Crowdedlight/DreamTeamCar/README.md

# DreamTeamCar
Repository for all code and documents regarding our AI Car project
