Crowdedlight/DreamTeamCar/Tex Filer/Include/Forside.tex

\begin{titlepage}
\begin{center}

% Upper part of the page. The '~' is needed because \\
% only works if a paragraph has started.

%keepaspectratio, trim={0.33\textwidth} {0.67\parentheight} {0.33\textwidth} 0, clip

%\includegraphics[width=1\textwidth, page=7, trim={0.06\textwidth} {0.025\textwidth} {0.06\textwidth} {0.025\textwidth}, clip]{logo.pdf}~\\[0.5cm]

\textsc{\Huge Syddansk Universitet}\\[1.5cm]
\textsc{\huge \color{sdu_grey} Mærsk McKinney Møller Instituttet}\\[0.5cm]

\textsc{\LARGE \color{sdu_grey} Robot Teknologi}\\[0.5cm]

% Title
\HRule \\[1ex]
{ \Huge \bfseries Pole Position \\[1ex] }

\HRule \\[1.5cm]

% Author and supervisor 
\begin{minipage}{0.50\textwidth}
\begin{flushleft}\large
\emph{Gruppe 7:}\\
\vspace{4mm}
Peter Gilsaa \\
05/05-95 \\
\href{mailto:pegil14@student.sdu.dk}{\color{sdu_blue}pegil14@student.sdu.dk}\\
\vspace{4mm}
Mads Tilgaard Jensen\\
04/01-94 \\
\href{mailto:madst14@student.sdu.dk}{\color{sdu_blue}madst14@student.sdu.dk}\\
\vspace{4mm}
Eskild Andresen\\
27/03-92 \\
\href{mailto:esand14@student.sdu.dk}{\color{sdu_blue}esand14@student.sdu.dk}\\
\vspace{4mm}
Sara Marie Gadgaard\\
04/09-92 \\
\href{mailto:sagad13@student.sdu.dk}{\color{sdu_blue}sagad13@student.sdu.dk}\\
\vspace{4mm}
Frederik Mazur Andersen\\
01/11-93 \\
\href{mailto:fande14@student.sdu.dk}{\color{sdu_blue}fande14@student.sdu.dk}\\
\end{flushleft}
\end{minipage}
\begin{minipage}[c][2cm]{0.45\textwidth}
\begin{flushright} \large
\vspace{2cm}
\emph{Kursus Kode:} \\
RB-AUR2-U1 \\
\vspace{2cm}
\emph{Vejleder:} \\
Dorthe Sølvason  \\
\vspace{2cm}
\emph{Projekt Udleveret:} \\
27. Februar 2015 \\
\vspace{4mm}
\emph{Projektet afleveret:} \\
27. Maj 2015
\end{flushright}
\end{minipage}

\vfill

% Bottom of the page
{\Large Autonome Robotter 2}
\end{center}
\end{titlepage}
