Crowdedlight/DreamTeamCar/Tex Filer/Include/Informationer.tex

\section*{Informationer}
\begin{tabularx}{\hsize}{lX}
Kursus:		    &	Autonome robotter\\
Projekttitel:	&	Pole Position\\
Gruppe:			&	7\\
Vejleder:		&	Dorthe Sølvason\\
\\
Universitet:	&	Syddansk Universitet\\
Periode:		&	27. Februar - 27. Maj 2015\\
Uddannelse:		&	Robotteknologi\\
\\
Sideantal:		&	\pageref{LastPage} \\
CD:				&	$ATmega32A$ $Datasheet.pdf$     \hspace{1.85cm}   $AVR$ $Instruction$ $Set.pdf$ \\
                &   $CNY70$ $Datasheet.pdf$         \hspace{2.6cm}   $L293$ $Datasheet.pdf$ \\
                &   $LIS35DE$ $Datasheet.pdf$       \hspace{2.3cm}   $Lookup-Tabel-Bremse.xlsx$ \\
                &   $MMA1270KEG$ $Datasheet.pdf$    \hspace{1.05cm}   $Rapport.pdf$ \\
                &   $Sensorboard\_tegning.pdf$      \hspace{2.1cm}   $TCST1230$ $Datasheet.pdf$ \\
                &   $Tidsplan.pdf$

\\

Underskrifter:\\
\end{tabularx}
\vspace{1.3cm}
%%%%%%%%%%%%%%%%%%%%%%%%%%%
% Underskrift

%%%%%%%%%%%%%%%%%%%%%%%%%%%
\noindent\begin{tabularx}{\hsize}{XX}
\\
--------------------------------------------- & --------------------------------------------- \\
Eskild Andresen & Frederik Mazur Andersen \\

\\\\\\\\
--------------------------------------------- & --------------------------------------------- \\
Mads Tilgaard Jensen & Peter Gilsaa \\
\\\\\\\\
--------------------------------------------- &  \\
Sara Marie Gadgaard  \\
\end{tabularx}
