Crowdedlight/DreamTeamCar/Tex Filer/Include/Litteraturliste.tex

\section{Litteraturliste}
\subsection{Kilder}
\begin{enumerate}
\item Atmel, 8-bit AVR: Instruction Set.(PDF), \\
\url{https://e-learn.sdu.dk/bbcswebdav/pid-3951952-dt-content-rid-5381354_2/courses/RB-AUR2-U1-1-F15/AVR\%20Instruction\%20Set\%281\%29.pdf} 26/05-2015
\item Muhammed Ali Mazidi, Sarmad Naimi og Sepehr Naimi: AVR Microcontroller and Embedded System: Using Assembly and C, 2011
\item Schoolphysics: Circular Motion, Cars on flat track, \\
\url{http://www.schoolphysics.co.uk/age16-19/Mechanics/Circular\%20motion/text/Cars_cornering/index.html} 20/05-2015.
\item Søren Hassing og René Skov Hansen: Elektrofysik (E-ANA 1), supplerende noter.(PDF), Efterår 1997
\end{enumerate}

\subsection{Datasheets}
\begin{enumerate}
\item Atmega32A - Atmel, \\
\url{https://e-learn.sdu.dk/bbcswebdav/pid-3951952-dt-content-rid-5381352_2/courses/RB-AUR2-U1-1-F15/ATmega32A\%20datasheet\%281\%29.pdf} 26/05-2015
\item CNY70 - Vishay, \\
\url{http://www.vishay.com/docs/83751/cny70.pdf} 26/05-2015
\item L293 - Texas, \\
\url{http://users.ece.utexas.edu/~valvano/Datasheets/L293d.pdf} 26/05-2015
\item MMA1270KEG - Freescale Semiconductors, \\
\url{http://cache.freescale.com/files/sensors/doc/data_sheet/MMA1270KEG.pdf} 26/05-2015
\item TCST1230 - Vishay, \\
\url{http://www.vishay.com/docs/83765/tcst1230.pdf} 26/05-2015
\end{enumerate}
