Crowdedlight/DreamTeamCar/Tex Filer/Include/motorstyr_brems.tex

\section{Motorstyring og bremsning}
For at finde den bedste måde at bremse på, er der lavet en test med tre scenarier. I alle tre scenarier er banen den samme. Banen består af ti lige skinner. De første seks er tilsluttet strømforsyningen, mens de fire sidste er tilsluttet en kontakt, så skinnerne kan frakobles strømforsyningen, kortsluttes eller strømmen kan vendes. Motoren er koblet direkte til banen, dvs. at den styres vha. strømforsyningen. I alle test er spændingsfaldet over motoren på 15volt. Det hele filmes. \\

I første test var de sidste fire skinner ikke tilsluttet til strømforsyningen ydermere var de ikke kortsluttet. Her viste testen at bilen skulle bruge mere end 70cm for at stoppe helt. \\
I anden test var de sidste fire skinner kortsluttet. Dvs. at motoren blev kortsluttet efter at have kørt på de seks første skinner. Her var bremselængden 67cm. \\
I tredje test og sidste test løb strømmen den modsatte vej igennem motoren på de sidste fire skinner. Her var bremselængde kun 32cm. \\

En H-bro er et kredsløb som kan styre en motor. Den er som regel opbygget af NPN/PNP transistor eller MOSFETS og kan fås som IC'er så som L293. L293 er opbygget af NPN/PNP transistorer. Ved at tilslutte motoren til en H-bro giver det mulighed for at styre retningen af motoren og at kortslutte motoren. Muligheden for at styre retningen af motoren, bruges til bremsning af bilen.

For at kunne vende strømmen i motoren er der placeret en H-bro. H-broen der anvendes er L293. Denne IC består af to H-broer, det er dog kun den ene som anvendes. H-broen har 3 forbindelser til microcontrolleren: enable, 1A og 2A. Disse tre forbindelser bruges til at styrer motoren. Se figur \ref{hbro_forbindelse} for mulige kombinationer. 

\begin{figure}[h!]
\center
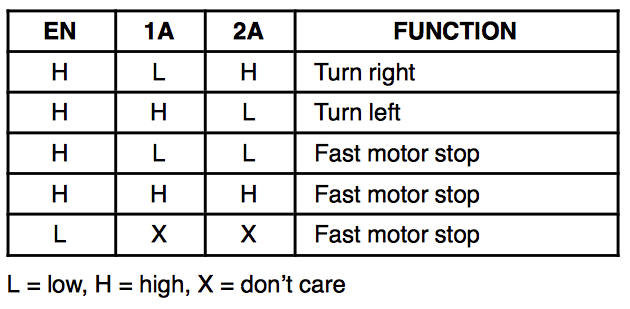
[picture p10: Tex Filer/Graphics/h-bro_forbindelse.png]

\caption{H-broens 3 forbindelser og hvordan de kan sættes}
\label{hbro_forbindelse}
\end{figure}

PWM signalet fra microcontrolleren er koblet til 1A, mens enable og 2A er koblet til I/O pins. Som det ses i figur \ref{hbro_forbindelse} vil et PWM signal medføre at motoren skifter mellem "Fast motor stop" og "turn left". Dette er dog ikke et problem da man på lige strækninger kører med 100\% PWM hvilket svarer til at 1A konstant er høj. Derfor får man ikke lavere topfart i forhold til at køre uden H-bro. Dog vil det kræve et højere PWM signal for at holde samme fart i svingene i forhold til uden at bruge H-broen. Dette medvirker at bilen har et højere energiforbrug og mere spild energi, men der er intet krav om at bilen skal være effektiv. \\

Ved opbremsning ”slukkes” for PWM signalet og 2A sættes høj. Dette medfører at spændingen over motoren vendes. Opbremsningen sker kun kortvarigt indtil bilen kommer ned i en hastighed, hvor at den ikke falder af i svingene. For at finde det optimale tidspunkt at bremse på er der lavet en række test og beregninger. Dette kan der læses nærmere om i afsnit \ref{bremse}.
