Crowdedlight/DreamTeamCar/Tex Filer/Include/Forord.tex

\renewcommand{\abstractname}{Forord}
\section{Forord}
Rapporten er udarbejdet af studerende fra 2. semester, derfor henvender rapporten sig til studerende fra 2. semester eller højere. \\
Formålet er at give læseren en forståelse, overblik over projektets omfang og lede læseren frem til løsningen af det færdige projekt.\\
Rapporten er bygget op omkring projektet Pole Position.\\
