Crowdedlight/DreamTeamCar/Tex Filer/Include/Resume.tex

\newpage
%\thispagestyle{empty}
%\renewcommand{\abstractname}{Resume}
\section{Resume}
Denne rapport er dokumentation for en modificeret racerbil. Bilen er modificeret således at den kan justere sin hastighed hensigtsmæssigt og derved opnå den hurtigste omgangstid.\\
For at realisere dette er bilen udstyret med tre sensorer: En reflektiv optisk sensor, et accelerometer og transmissiv optisk sensor. Disse sensorer, samt elektromagnet og opbremsning håndteres af en microcontroller der forbinder disse elementer og gør bilen selvstændig. Bilen vil bestræbe sig på at køre med hurtigste omgangstid, med den kunstige intelligens, der er blevet lavet.\\ Flere sensorer, magneter og bremsemetoder er overvejet og testet før implementering. \\
