Crowdedlight/DreamTeamCar/Tex Filer/Rapport.pdf

Faculty of Engineering

Robotic Technology

# Pole Position

Gruppe 7:

Peter Gilsaa
pegil14@student.sdu.dk

Mads Tilgaard Jensen
madst14@student.sdu.dk

Eskild Andresen
esand14@student.sdu.dk

Sara Marie Gadgaard
sagad13@student.sdu.dk

Frederik Mazur Andersen
fande14@student.sdu.dk

Vejleder:
Dorthe Sølvason

Projekt Udleveret:
27. Februar 2015
Projektet afleveret:
27. Maj 2015

## Autonome Robotter 2

Pole Position

## Informationer

Kursus: | Autonome robotter
Projekttitel: | Pole Position
Gruppe: | 7
Vejledere: | Dorthe Sølvason
Universitet: | Syddansk Unniversitet
Periode: | 27. Februar - 27. Maj 2015
Uddannelse: | Robotteknologi

Sideantal:
CD: | Indholde?
Underskrifter:
——————————————— | ———————————————
Eskild Andersen | Frederik Mazur Andersen
——————————————— | ———————————————
Mads Tilgaard Jensen | Peter Gilsaa

———————————————
Sara Marie Gadgaard

Peter Gilsaa, Mads Tilgaard Jensen, Eskild Andresen, Sara Marie Gadgaard & Frederik Mazur Andersen

Side 1 af 26

Pole Position | 1. Resume

## 1 Resume

Denne rapport er dukumentation for en modificeret racer bil. bilen er modificeret således at den kan justere sin hastighed hensigtsmæssigt og derved opnå den korteste omgangstid. For at realisere dette er bilen udstyret med tre sensor: En reflektiv optisk sensor, et accelerometer og transmissiv optisk sensor. Disse sensorer, samt elektromagnet og bremse håndteres af en microcontroller der forbinder disse elementer og gør bilen selvstændig. Bilen vil bestræbe sig på at køre med hurtigste omgangstid, med den kunstige intelligens den er blevet lavet.
sensorer, magnet og bremse metode er overvejet før valg.

## 2 Forord

Rapporten er udarbejdet af 2. semester studerende derfor henvender rapporten sig også til 2. semetser studerende eller højre.
Formålet er at give læseren en forståelse og overblik for projektets omfang og lede læseren frem til løsningen af det færdige projekt.
Rapporten er bygget op omkring projektet pole position.

Side 2 af 26

Pole Position | INDHOLD

## Indhold

1 Resume | 2
2 Forord | 2
3 Indledning | 5
4 Stregsensor | 6
5 Elektromagnet | 7
6 Måling af farten - Wheelspeed Sensor | 9
7 Måling af afstand - Wheelspeed Sensor | 12
8 Motorstyring og bremsning | 12
9 Sving og Bremse | 13
10 Stregsensor | 16
11 Elektromagnet | 17
12 Kommunikation mellem computer og bil | 18

Side 3 af 26

Pole Position | INDHOLD
13 Litteraturliste | 20
13.1 Kilder | 20
13.2 Datasheets | 21
14 Ordliste | 21
15 Symbolliste | 21
16 Bilag | 22
16.1 Elektromagnet-kraftmåling | 23
16.2 Beregning af gearing | 25
16.2.1 Periode tid ved 4 m/s | 25
16.3 Lookup Table - Bremse Værdi | 25

## Todo list

indsæt afsnit for konstant hastighed og mapning | 9
indsæt datablad | 10
TCST1230 s. 3 | 10
indsæt datablad | 11
henvis til lookup table og sørg for table har korrekte enheder | 11
indsæt afsnit label | 12
indsæt afnist | 12
Skal dette med? | 13
afsnit udfyldes | 13
kort intro | 13
Hvilket bilag? | 20
lav en beregning fra tid til m/s, og forklar hvad enhed tiden er | 25

Side 4 af 26

Pole Position | 3. Indledning

## 3 Indledning

skriv noget kort om indledning

### 3.1 Projekt beskrivelse

skriv noget kort om projekt beskrivelsen

### 3.1.1 Problemanalyse

Projektet skal få en elektrisk bil at hurtigst muligt at kører omgange på en vilkårlig bane uden at ryge af banen. For at opnå dette kræves forskellige sensorer som skal bygges og programmeres. Formålet er at opnå kendskab med programmering i Assembler og opbygning af sensor kredsløb, samt få programmering og sensorer til at arbejde sammen. Projektet kan opskrives til følgende:

- Bluetooth Kommunikation med bilen via en bestemt Bluetooth protokol
- Byg og monter sensor kredsløb til de forskellige nødvendige sensorer
- Algoritme der kortlægger banen
- Algoritme der bruger den kortlagt bane og sensor data til at sætte optimal hastighed

### 3.1.2 Problemformulering

Hvordan opbygges og programmeres en elektrisk bil til selv at kunne kører hurtigste tid på en vilkårlig bane? Denne problemstilling vil vi arbejde med i dette projekt, og dertil skal disse problemer løses:

- Hvordan kommunikerer man med bilen?
- Hvilke sensorer skal benyttes for at gøre bilen selvkørende med så høj fart som

muligt?
- Hvilken elektromagnetisk sensor/ Aktuator skal bruges?
- Hvordan detekteres målstregen med en sensor?
- Hvordan programmeres Micro kontrolleren så den kan kortlægge den vilkårlige bane?
- Hvordan programmeres bilen til at udnytte den kortlagte bane til at kører hurtigst

muligt?
- Hvordan fås bilen til aktivt at bremse?

### 3.1.3 Afgrænsning

I denne opgave begrænser vi os til bygge sensorer kredsløb og programmere Micro kontrolleren til den elektriske bil. Vi skal ikke bygge bilen fra bunden, men modificerer en eksisterende model til at kunne styres gennem vores Micro kontroller. Bluetooth kommunikations protokollen er også bestemt for os, men vi skal selv implementerer denne og kan

Side 5 af 26

Pole Position | 3.2 Rapportstruktur

også udvide den.

Derudover laver vi et lille program der kan snakke sammen med bilen til brug for testing og data modtagelse. Dette program er skrevet i Vb.net for ikke at bruge for meget tid og energi på det, da det kun benyttes til udvikling af bilen.

Vores projekt kan derfor fortolkes til at programmerer en Micro Kontroller til at modtage signaler fra sensorer og derudfra kortlægge en bane og give signaler til motoren for at sætte den hurtigste omgangstid.

### 3.1.4 Konkurrenceregler

Den 29. maj 2015 afholdes poleposition konkurrencen. Her vinder det hold som har den korteste omgangstid. Der er visse krav til bilen for at gøre konkurrencen fair. Bilen skal kunne køre af sig selv og skal således starte når den sættes på banen. Det skal dog være muligt at sætte en hastighed eller stoppe bilen vha. bluetooth. Denne kommunikation skal overholde en protokol som senere vil blive uddybet. Selve banen består kun af rene højre eller venstre sving, dvs. at der minimum vil være en lige skinne mellem to sving. Bilens karosseri, dæk og undervogn må ikke ændres. Det er dog tilladt at lave mindre ændringer for at gøre plads til sensorer og lignende. Der må monteres permamagneter på bilen. Magneten som er monteret på bilen fra frabrikken må dog blive siddende. Der skal anvendes en elektromagnetisk sensor og/eller aktuator i projektet. Dette kan f.eks. være i

form af en elektromagnet.

### 3.2 Rapportstruktur

## 4 Stregsensor

På kørebanen til konkurrencen er der en hvis streg, som makere start. Det ønskes at kunne detektere dennne streg, for af vide hvornår bilen har kørt en omgang.
Til at dektektere start linjen, som er hvid skal den valgte sensor detekterer foreskellen mellem hvid og stort på banen.

Til det pågældende formål er en reflektiv optisk sensor blevet undersøgt og valgt. Den reflektive optiske sensore har fordelen at den er lille og fylder lidt.

### 4.1 CNY70

Den refleksive optiske sensor som er valgt, hedder CNY70. Sensoren fylder 7x7x6 mm og er placeret 0.2 mm fra den overflade den operere på.
CNY70’eren er fastmonteret på undervognene af bilen, som vender ned mod banen.

Side 6 af 26

Pole Position | 5. Elektromagnet

sensoren består af en diode og en fototransistor, da både diode og fototransistor vender ned mod banen, fungere den ved at lyset fra dioden reflektere i banen og fototransistoren opfangere det reflekterede lys og åbner alt efter hvor meget der bliver reflekteret.
Mørke farver absobere meget af lyset mens lyse farver reflektere dem.
(henvis til kredsløb for stregsensor)sensoren er forsynet med 5V, men kun når diodens

stråler reflekteres åbner transistoren og udgangsspændingen på output-benet bliver højt. Programmet til stregsensoren tjekker først på rising edge og registrere dette, så tjekker den for falling edge og registrere dette, microcontrolleren har nu dektekteret hele målstregen.

## 5 Elektromagnet

Elektromagneten er lavet til at holde bilen på banen. ved at aktivere elektromagneten sving burde den optimere bilens evne til at holde sig på banen, ved højre hastighed end udens elektromagnet.

### 5.1 Kernemateriale

En vigtig faktor i fremstilling af elektromagneter er materialet. Ud fra materialet bestemmes, elektromagnetens magnetiake evne, hvori materialets permabiliteten bestemmer hvor det kan lede et magnetisk felt. Permeabiliteten kan deles op i tre underemner, ferromagnetisk, paramagnetisk og diamagnetisk.
I diamagnetiske materialer er magnetiseringen ekstremt lille og har en lineær BH-kurve. Ved paramagnetiske materialer er magnetiseringen ligeledes meget lille, men større end diamagnetiske materialer og ligeledes har materialet en lineær BH-kurve. Ferromagnetiske materialer har en stor magnetisering, den magnetiske effekt skyldes herved de uparede elektroner der forekommer i nogle metaller. Ferromagnetiske materialer har en logistisk stigende HB-kurve.

Ferromagnetisk materiale kan nu deles op i to undergrupper, blødt materiale og hårdt materiale. Blødt materiale er er karakteret ved høj permeabilitet, lille hysteresekurve med lille koerciv felt og lille kulstofindhold. Bløde materialer er ofte en legering af jern og silicium eller nikkel.
Hårdt materiale er karakteriseret ved mindre permeabilitet end blødt materiale, bred hysteresekurve, stort koerciv felt og højt kulstofindhold. Hårde materialer er ofte en legering af jern med kulstof, aluminium eller wolfram.

### 5.2 Prøvemagnet

Som udgangspunkt er kernematerialet blevet antaget til at være stål da materialet er ferromagnetisk og hårdt. hvis der skulle laves en korrekt undersøgelse at kernematerialet ville

Side 7 af 26

Pole Position | 5.2 Prøvemagnet

det kræve en længere og meget tidskræven undersøgelse, derfor har dette kun været en overvejelse.
Næste overvejelse har været placering og form af elektromagnet. der er tre steder elektromagneten kan placeres på bilen, der er foran, bagpå eller under bilen.
Hverken trække eller skubbe elektromagneten er en effektiv løsning, det vil skabe uligevægt i bilen og flytte masse midtpunkt. ved en stærk elektomagnet vil man ændre friktions niveauet meget ved at have elektromagneten foran eller bagved, dvs. Hvis elektromagneten sidder bagpå vil der opstå meget friktion på baghjulene og mindre friktion på forhjulene. Fluxspredning er en faktor der skal tages hensyn til når formen til elektromagneten laves, der vil altid være fluxspredning med formen kan være med til at reducere det betydligt. fluxlinjerne beværger sig fra nord til syd for fuldt udbytte af elektromagnet bør nord og syd pol befinde sig over skinnerne så fluxlinjerne løber med skinnerne. Hvis elektromagneten formes som en hestesko vil nord og syd pege ned mod skinnerne. for at undgå for meget fluxspredning bør luftgabet imellem nord og syd i hesteskoen være så stor som muligt, men da der er begrænset plads underbilen, kan lufgabet ikke blive særlig stort og en del kraft vil gå tabt i både fluxspredning og fluxfringing (se journal).

Nu da materialet er bestemt, placeringen og formen, skal antal vindinger bestemmes, da der er en maks bredde på pladsen under elektromagneten, vil der kun være plads til en 660 vindinger, før elektromagneten vil komme for tæt på banen, hvilket vil sige den ikke må komme tættere på end 2mm da bilen har affjedring og køre skævt i svingene. elektromagneten må ikke røre skinnerne da den enten vil gå i mætning eller kortslutte, så derfor er afstanden fra elektromagneten til skinnerne vigtigt.

Test magneten er lavet ud fra forrige forhold og formlen for den magnetiske kraft i et luft gab (under idelle forhold) er givet ved:

Fmagn(x) = −

B²
g
2µ0

∗ Aj ∗ (

4x
lj
µr

+2x

− 1)

Hvor Bg er:

Bg(x) = µ0IN
lj
µr

+2x

Ud fra de overstående ligninger er kraften ideelt fundet til at være 1,309N. Virkeligt er den målt med en force sensor til at være 0,9367N. (henvis til journal)

Da 0,9367N er en meget lille kraft, bør de overvejes grundigt om elektromagneten vil blive en ulempe eller hjælp til bilen og hvor meget vil den lille kraft enlig kunne hjælpe med at forøge hastigheden i svingene. (henvis til peters afsnit)

Side 8 af 26

Pole Position | 6. Måling af farten - Wheelspeed Sensor

## 6 Måling af farten - Wheelspeed Sensor

I dette afsnit beskrives der hvordan en wheelspeed sensor udnyttes til at beregne farten bilen kører med. Der vil både blive beskrevet hardwaren til sensoren samt hvordan den softwaremæssigt bruger sensoren. Farten bliver brugt til at mappe banen samt kører med
konstant hastighed. Disse funktioner vil blive beskrevet i afsnit . | indsæt
afsnit
for konstant
hastighed og
mapning

indsæt
afsnit
for konstant
hastighed og
mapning

### 6.1 Fart Hardware - TCST1230

Vi benytter TCST1230, som er en optisk sensor, til at lave en fotogate. Sensoren består af en fotocelle og en vifte med 16 blade på. Hjulet med vifterne sidder på motorens akse og hver gang aksen drejer en omgang vil den bryde fotosensorens lys XX gange. Hver gang lyset brydes så fås en puls fra fotosensoren som sendes videre til micro-controlleren. Dette er illustreret i figur 1


Figur 1: 3D model af sensoren

Efter test er der sat flere blade på viften da for at præcist at kunne bruge målingerne fra sensoren krævede det en højere opløsning. Dette fås ved at tilføje flere blade til viften så vi får flere pulses pr. omdrejning af aksen. Der er således nu så 4 blade på viften hvilket giver os 4 pulse pr. akse omdrejning. Dette svarer til 16,8 pulses pr. hjul omdrejning.
Se afsnit ?? for udregningen af gearingen.
Dette giver en opløsning der er 4 gange bedre, end kun at have 1 vifte.
For bedre opløsning kunne der sættes flere vifter på, men kommer der for mange vifter på, vil det dog blive svært for sensoren at aflæse vifterne da deres mellemrum til sidst vil blive meget småt. Jo flere vifter der kommes på, jo sværere bliver det også at bygge ringen med vifterne.

Der bliver i dette tilfælde valgt at have 4 vifter da det kunne bygges forholdsvis let og det giver en opløsning der er høj nok til hvad vi ønskede. Ved blot 1 vifte kørte vi 2cm per omdrejning. Da vi ved hjulet kører 0,2381 omgange pr. motor omdrejning så kan længden den kører mellem hver puls udregnes ved at multiplicerer hjul omdrejninger med hjulets

Side 9 af 26

Pole Position | 6.1 Fart Hardware - TCST1230

omkreds:

0,2381 ∗ 8,5 = 2,02cm

Dette er ikke ret præcist da vi så kun kan aflæse længden/farten i intervaller af 2cm. Det

blev så sat 4 vifter på og dette giver en præcision på:

(0,2381/4) ∗ 8,5 = 0,51cm

Dette er markant bedre da den nu kun kører 0,51cm før den får en puls og udregner længde og hastighed. Så der fås flere mindre intervaller der kan tjekkes og reageres på.

Som det kan ses på tegningen af kredsløbet i figur 2 så er der sat nogle modstande og en kondensator på sensorens kredsløb.

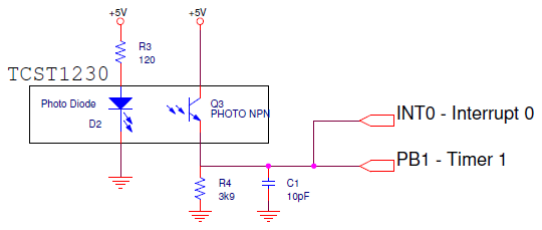
[picture p16: figure]

Figur 2: Kredsløbet til TCST1230 Sensoren

Modstanden R3 i figur 2 er der for at sørge for at strømmen over dioden D2 ikke bliver
højere end den kan tåle. Dioden kan nemlig kun klarer 30mA ifølge databladet. | indsæt
| data-
Modstanden R4 virker som en pulldown modstand der sørger for at hive signalet langt | blad
nok ned, når fototransistoren ikke modtager lys, så der er logisk lavt signal.

Kondensatoren C1 benyttes til at sorterer små signaler fra. Hvis signalet ”hopper” frem og tilbage ved en overgang fra logisk lavt til logisk højt vil kondensatoren tage de små hurtige skift og sorterer dem fra. På denne måde fjernes en del af støjen. Der blev gennem oscilloskop observeret pral på sensoren ved TTL signal behandling. Der var benyttet en forkert metode til at opbygge sensoren på. Der var anvendt en struktur som forårsagede
at diode spændingen over fototransistoren ikke kunne komme under 0.6V. Der blev derfor
udarbejdet en anden struktur som set i databadet s. 3. Modstanden benyttet til dioden | TCST1230
blev udregnet vha. Ohms lov og ved at sætte strømmen lig 30mA. Dette resulterede i en | s. 3
modstand for R3 på 120 Ohm.

Side 10 af 26

Pole Position | 6.2 Fart Software
R4, som er pulldown modstanden, blev beregnet ved at kigge på figur 8 i databladet . Her | indsæt
| data-
| blad

blev modstanden udregnet til ca. 4K Ohm. Der anvendes her en 3.9K Ohm modstand

### 6.2 Fart Software

Sensorens output er sat på ”PB1” og ”PD3” som går til ”Timer1” og ”INT0” i microcontrolleren. Så hver gang den får en puls så bliver timeren og interruptet triggeret. Timeren bliver benyttet til at finde længden den har kørt. Dette er beskrevet i afsnit ??.

Interruptet benyttes sammen med Timer0 til at finde farten. Timer 0 er sat op så den inkrementer hvert 0.000064 sekund. Hvilket svarer til den inkrementerer hvert 64. mikrosekund. Dette er sat ved at bruge en prescale på 1024. Da clock frekvensen på micro-processoren er 16MHz udregnes det således:

1/(16000000/1024) = 0,000064sek = 64mikrosekunder

Dette bruges for at finde tiden mellem pulses som kan benyttes som udtryk for farten. Timeren er ligeledes sat op så hvis der er overflow i Timer0 så kaldes et andet interrupt der blot nulstiller timeren og den fortsætter så.

Flowdiagrammet i figur 3 viser processen hver gang Interruptet bliver kaldt. Hvilket sker hver gang sensoren sender en puls.

Figur 3: Flowchart af softwaren til måling af farten

Der slåes først interrupts fra globalt, for at dette interrupt ikke bliver afbrudt af et andet interrupt. Herefter indlæses den værdi tælleren er nået til. Denne værdi gemmes i registeret R26, som er vores ”målt fart” register. Så ligges der 0 ind i Timer0, for at nulstille den. På den måde får vi hvor mange gange der er gået 64 mikrosekunder på 1 puls. F.eks. hvis
der går 10 optællinger mellem timer puls, så har bilen farten: 7,9 m/s.
Dette kan ses i lookup table i afsnit | henvis
| til look- up table og sørg for tab- le har korrekte

henvis
til lookup table
og sørg
for table har
korrekte

Inden interruptet sluttes kaldes nogle labels der benyttes til at bestemme hvor på banen

Side 11 af 26

Pole Position | 7. Måling af afstand - Wheelspeed Sensor
den er. Disse er beskrevet i afsnit XX. | indsæt
| afsnit
Til sidst så slås interrupts til igen og der returneres til der koden var nået til, indtil næste | label
interrupt bliver kaldt.

## 7 Måling af afstand - Wheelspeed Sensor

I dette afsnit beskrives hvordan bilen måler hvor langt den er kørt. Her benyttes den samme sensor som bruges til udregning af farten der køres med i afsnit 6.
Afstanden bilen har kørt bruges til at mappe banen som der kan læses nærmere om i afsnit
XX | indsæt
| afnist

### 7.1 Afstand Hardware - TCST1230

Da sensoren er den samme som benyttes til måling af fart vil dens hardware ikke blive beskrevet her. Der henvises i stedet til afsnit 6.1
Den eneste ændring på hardwaren er at sensores udgangssignal til micro-controlleren går på indgang ”PB1.”

### 7.2 Afstand Software

Hver gang sensoren sender en puls til ”PB1” på micro-controlleren så vil Timer1 inkrementer med en. Timer1 er valgt da det er en 16bit timer og derfor kan der køres 327,7 meter før timeren giver overflow. Udregningen er som følger:

16bit = 2¹
6 ∗ 0.5cm(pr.puls) = 32768cm = 327,7meter

Dette er rigeligt til formålet, da efter hver lige strækning vil tælleren nulstilles.

Da der vides hvor mange pulses der går på en hjul omdrejning, nemlig 16,8, så kan der ved at tælle pulses udregnes hvor langt den har kørt. For udregning af antal pulses pr. omdrejning se afsnit 16.2

Timer1 er opsat med en prescale der tager udgangspunkt i et ekstern input. Dette betyder at det eksterne signal benyttes som clock-frekvens med rising edge. Rising edge betyder at en periode tager udgangspunkt i signalet på vej op i stedet for på vej ned.

## 8 Motorstyring og bremsning

For at finde den bedste måde at bremse på, er der lavet en test med tre scenarier. I alle tre scenarier er banen den samme. Banen består af 10 skinner. De første seks er tilsluttet strømforsyningen, mens de fire sidste er tilsluttet en kontakt så skinnerne kan frakobles

Side 12 af 26

Pole Position | 9. Sving og Bremse

strømforsyningen, kortsluttes eller strømmen vendes. Motoren er koblet direkte til banen, dvs. at den styres vha. strømforsyningen. I alle test er spændingsfaldet over motoren på 15 volt. Det hele filmes med højhastighedskamera.

I første test var de sidste fire skinner ikke tilsluttet til strømforsyningen ydermere var de ikke kortsluttet. Her viste testen at bilen skulle bruge mere en 70 cm. for at stoppe helt. I anden test var de sidste fire skinner kortsluttet. Dvs. at motoren blev kortsluttet efter at have kørt på de seks første skinner. Her var bremselængden 67 cm.
I tredje test og sidste test løb strømmen den modsatte vej igennem motoren på de sidste fire skinner. Her var en væsentlig kortere bremselængde på kun 32 cm.

For at kunne vende strømmen i motoren er der placeret en h-bro. H-broen der anvendes er l293. Denne ic består af to h-broer, det er dog kun den ene som anvendes. H-broen er koblet til micro-controlleren med tre forbindelser. De tre forbindelser er enable, 1A og 2A.

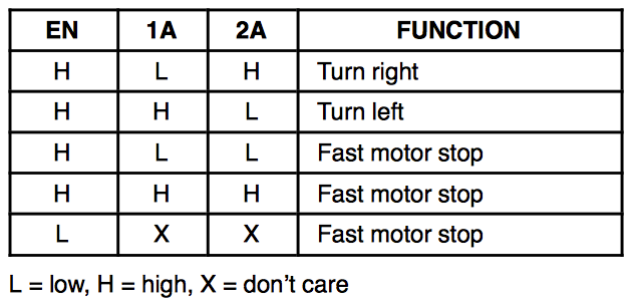
[picture p17: figure]

Figur 4: H-broens 3 forbindelser og hvordan de kan sættes

PWM signalet fra micro-controlleren er koblet til 1A, mens enable og 2A er koblet til almindelige i/o pins. Som det ses vil et PWM signal medføre at motoren skifter mellem Fast

motor stop og turn left. Dette er dog ikke et problem da man på lige strækninger kører med 100% PWM hvilket svarer til at 1A konstant er høj. Derfor får man ikke lavere topfart i

forhold til at køre uden h-bro. Dog vil det kræve et højere PWM signal for at holde samme
fart i svingene i forhold til uden at bruge H-broen. Dette medvirker at bilen har et høje-
re energiforbrug og mere spild energi, men der er intet krav om at bilen skal være effektiv. | Skal
| dette
Ved opbremsning ”slukkes” for PWM signalet og 2A sættes høj. Dette medfører at motoren | med?
prøver at køre den modsatte vej. Dette gøres kun kortvarigt så bilen kommer ned i en hastighed som gør at den ikke falder af i svingene. For at finde det optimale tidspunkt at
bremse på er der lavet en række test og beregninger. Dette kan der læses nærmere om i
afsnit . | afsnit
| udfyldes

## 9 Sving og Bremse

I dette afsnit vil der.... | kort
| intro

Side 13 af 26

Pole Position | 9.1 Sving

### 9.1 Sving

Bilen skal deltage i en hastighedskonkurrence, derfor er der blevet lagt vægt på at optimere bilens kørsel. For at kunne optimere omgangstiden skal der benyttes flere forskellige fysiske ligninger. Disse bruges til at finde bremsepunkterne og hastighedsgrænser. Bilen er blevet udstyret med en wheel speed sensor således at hastigheden kan overvåges og benyttes løbende i ligningerne.

Før nogle af beregningerne kan laves skal tyngdepunktet i bilen findes. Dette gøres ved hænge bilen i en snor, tage et billede og derefter hænges den i et andet punkt. Stedet hvor fortsættelsen af snorene krydser hinanden indikerer massemidtpunktet, som vist i figur 5.

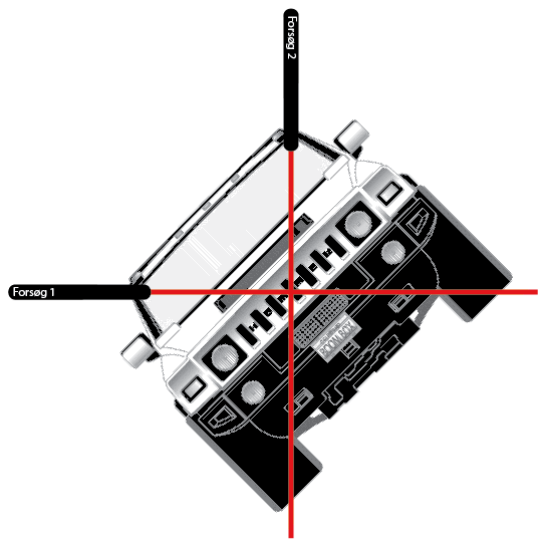
[picture p18: figure]

Figur 5: Massemidtpunkt

Efter at have fundet massemidtpunktet,
måles afstanden fra punktet til banen. Denne distance benyttes herefter i en formel, der indikerer hvor hurtigt man kan køre i et sving.

F art(v) = (r ∗ g ∗ b/h)

1
2 ,
r = radius,
g = tyngdekraft,
b = bils bredde,
h = massemidtpunkt afstand fra jord.

For at optimere bilens fysiske egenskaber kan flere ting ændres. Opgaveformuleringen begrænser nogle muligheder såsom slibning af dæk, hvilket giver større overfladeareal og derved større friktion.

Derimod forbydes det ikke at justere bilens affjedring, hvilket giver ca. 3mm i massemidtpunktshøjde og derved højere teoretisk hastighed i svingene. Resultaterne for forskellige opsætninger kan ses i tabellen 1.

Side 14 af 26

Pole Position | 9.2 Bremse
Opsætning | Indre sving (m/s) | Ydre sving (m/s)
Standard u. perma, u. elektro | 2.759 | 3.169
Standard m. perma, u. elektro | 3.705 | 4.257
Standard u. perma, m. elektro | 3.353 | 3.852
Standard m. perma, m. elektro | 4.046 | 4.650
Sænket u. perma, u. elektro | 2.992 | 3.438
Sænket m. perma, u. elektro | 4.019 | 4.617
Sænket, u. perma, m. elektro | 3.636 | 4.178
Sænket, m. perma, m. elektro | 4.390 | 5.043

Tabel 1: Forskellige opsætningers resultater

Bredde af bil = 0.062m, Svingradius Ydre = 0.33m Svingradius Indre = 0.25m, Tyngdekraft = 9.82m/s²

Permanent magnetkraft v. 2mm = 1.326N, Elektromagnet v. 2mm = 0.9366N/4.683m/s²
Massemidtpunkthøjde = 0.02m, Affjedring = 0 − 0.003m. (0.33 ∗ 9.82 ∗ 0.062/0.017)⁽1/2) = 3.438m/s.

Når det teoretiske maksimum er fundet skal resultatet implementeres i koden. Da bilen ikke har et differentiale vil den decelerere i svinget. Derfor er det nødvendigt i koden at tjekke den reelle hastighed bilen kører og sammenligne med den teoretiske. Dette gøres ved hjælp af wheelspeed sensoren. Hvis der går for lang tid mellem pulsene øges bilens hastighed en smule. Hvis der går for kort tid mellem pulsene sænkes bilens hastighed en smule. Denne subroutine eksekveres gennem svinget således at hastigheden hele tiden reguleres til at være tættest det teoretisk mulige.

### 9.2 Bremse

En stor del af optimeringen består af at finde det korrekte bremsepunkt. Jo senere der bremses jo hurtigere bliver omgangstiderne. For at finde disse bremsepunkter benyttes formlen:

V f = V i + 2 ∗ a ∗ d

Vf = maksimal fart i sving, Vi = nuværende fart, a = deceleration(22.06m/s² ) og d =

distance.

Denne kigger på den maksimale teoretiske svinghastighed, bilens hastighed, deceleration og distancen til bremsepunktet. Da disse værdier ofte er kommatal, benyttes et lookup-table, som indeholder bremselængden som funktion af periodetiden fra wheelspeed sensoren.

Side 15 af 26

Pole Position | 10. Stregsensor

Lookup-tabellen i bilag 16.3 tager udgangspunkt i en bestemt periodetid. Periodetiden benyttes til at udregnes hastigheden i m/s og sættes ind i ovenstående formel. Konstanten

A, er fundet ud fra et eksperiment, hvor bilen filmes mens den bremser. Videoen analyseres vha. programmet LoggerPro, som kan måle hastigheden og accelerationen. Ud fra disse værdier kan bremselængden findes. Denne måles i pulses, hvor det vides at 1 puls er lig med 0.005m. Dette er udregnet ud fra bilens gearing og hjulenes omkreds.

Efter bilen har mappet banen benyttes Lookup-tabellen til at finde det optimale bremsepunkt. Det gøres ved at tjekke wheel speed sensoren og sammenligne denne værdi med værdierne i lookup-tabellen, for at finde bremselængde. Samtidig udregnes afstanden til svinget således. Når afstanden til svinget er lig med bremselængde begynder bilen at bremse. Dette gøres ved at køre motoren baglæns indtil periodetiden i wheel speed sensoren er lig med den maksimale teoretiske periodetid for svinget.

Ud fra dette kan den optimale bremsedistance opnås og derved en hurtigere omgangstid. Da der kan være en del usikkerhed omkring testresultater osv. benyttes den optimale bremsedistance ikke i første omgang, da det kan resulterer i at bilen ryger af banen. I stedet øges bremsedistance i første omgang således at bilen med sikkerhed for sat en omgangstid. Herefter vil bilen i de følgende omgange nedsættes bremsedistancen indtil det teoretiske maksimum nås.

## 10 Stregsensor

På kørebanen til konkurrencen er der en hvis streg, som makere start. Det ønskes at kunne detektere dennne streg, for af vide hvornår bilen har kørt en omgang.
Til at dektektere start linjen, som er hvid skal den valgte sensor detekterer foreskellen mellem hvid og stort på banen.

Til det pågældende formål er en reflektiv optisk sensor blevet undersøgt og valgt. Den reflektive optiske sensore har fordelen at den er lille og fylder lidt.

### 10.1 CNY70

Den refleksive optiske sensor som er valgt, hedder CNY70. Sensoren fylder 7x7x6 mm og er placeret 0.2 mm fra den overflade den operere på.
CNY70’eren er fastmonteret på undervognene af bilen, som vender ned mod banen.

sensoren består af en diode og en fototransistor, da både diode og fototransistor vender

Side 16 af 26

Pole Position | 11. Elektromagnet

ned mod banen, fungere den ved at lyset fra dioden reflektere i banen og fototransistoren opfangere det reflekterede lys og åbner alt efter hvor meget der bliver reflekteret.
Mørke farver absobere meget af lyset mens lyse farver reflektere dem.
(henvis til kredsløb for stregsensor)sensoren er forsynet med 5V, men kun når diodens

stråler reflekteres åbner transistoren og udgangsspændingen på output-benet bliver højt. Programmet til stregsensoren tjekker først på rising edge og registrere dette, så tjekker den for falling edge og registrere dette, microcontrolleren har nu dektekteret hele målstregen.

## 11 Elektromagnet

Elektromagneten er lavet til at holde bilen på banen. ved at aktivere elektromagneten sving burde den optimere bilens evne til at holde sig på banen, ved højre hastighed end udens elektromagnet.

### 11.1 Kernemateriale

En vigtig faktor i fremstilling af elektromagneter er materialet. Ud fra materialet bestemmes, elektromagnetens magnetiake evne, hvori materialets permabiliteten bestemmer hvor det kan lede et magnetisk felt. Permeabiliteten kan deles op i tre underemner, ferromagnetisk, paramagnetisk og diamagnetisk.
I diamagnetiske materialer er magnetiseringen ekstremt lille og har en lineær BH-kurve. Ved paramagnetiske materialer er magnetiseringen ligeledes meget lille, men større end diamagnetiske materialer og ligeledes har materialet en lineær BH-kurve. Ferromagnetiske materialer har en stor magnetisering, den magnetiske effekt skyldes herved de uparede elektroner der forekommer i nogle metaller. Ferromagnetiske materialer har en logistisk stigende HB-kurve.

Ferromagnetisk materiale kan nu deles op i to undergrupper, blødt materiale og hårdt materiale. Blødt materiale er er karakteret ved høj permeabilitet, lille hysteresekurve med lille koerciv felt og lille kulstofindhold. Bløde materialer er ofte en legering af jern og silicium eller nikkel.
Hårdt materiale er karakteriseret ved mindre permeabilitet end blødt materiale, bred hysteresekurve, stort koerciv felt og højt kulstofindhold. Hårde materialer er ofte en legering af jern med kulstof, aluminium eller wolfram.

### 11.2 Prøvemagnet

Som udgangspunkt er kernematerialet blevet antaget til at være stål da materialet er ferromagnetisk og hårdt. hvis der skulle laves en korrekt undersøgelse at kernematerialet ville det kræve en længere og meget tidskræven undersøgelse, derfor har dette kun været en overvejelse.

Side 17 af 26

Pole Position | 12. Kommunikation mellem computer og bil

Næste overvejelse har været placering og form af elektromagnet. der er tre steder elektromagneten kan placeres på bilen, der er foran, bagpå eller under bilen.
Hverken trække eller skubbe elektromagneten er en effektiv løsning, det vil skabe uligevægt i bilen og flytte masse midtpunkt. ved en stærk elektomagnet vil man ændre friktions niveauet meget ved at have elektromagneten foran eller bagved, dvs. Hvis elektromagneten sidder bagpå vil der opstå meget friktion på baghjulene og mindre friktion på forhjulene. Fluxspredning er en faktor der skal tages hensyn til når formen til elektromagneten laves, der vil altid være fluxspredning med formen kan være med til at reducere det betydligt. fluxlinjerne beværger sig fra nord til syd for fuldt udbytte af elektromagnet bør nord og syd pol befinde sig over skinnerne så fluxlinjerne løber med skinnerne. Hvis elektromagneten formes som en hestesko vil nord og syd pege ned mod skinnerne. for at undgå for meget fluxspredning bør luftgabet imellem nord og syd i hesteskoen være så stor som muligt, men da der er begrænset plads underbilen, kan lufgabet ikke blive særlig stort og en del kraft vil gå tabt i både fluxspredning og fluxfringing (se journal).

Nu da materialet er bestemt, placeringen og formen, skal antal vindinger bestemmes, da der er en maks bredde på pladsen under elektromagneten, vil der kun være plads til en 660 vindinger, før elektromagneten vil komme for tæt på banen, hvilket vil sige den ikke må komme tættere på end 2mm da bilen har affjedring og køre skævt i svingene. elektromagneten må ikke røre skinnerne da den enten vil gå i mætning eller kortslutte, så derfor er afstanden fra elektromagneten til skinnerne vigtigt.

Test magneten er lavet ud fra forrige forhold og formlen for den magnetiske kraft i et luft gab (under idelle forhold) er givet ved:

Fmagn(x) = −

B²
g
2µ0

∗ Aj ∗ (

4x
lj
µr

+2x

− 1)

Hvor Bg er:

Bg(x) = µ0IN
lj
µr

+2x

Ud fra de overstående ligninger er kraften ideelt fundet til at være 1,309N. Virkeligt er den målt med en force sensor til at være 0,9367N. (henvis til journal)

Da 0,9367N er en meget lille kraft, bør de overvejes grundigt om elektromagneten vil blive en ulempe eller hjælp til bilen og hvor meget vil den lille kraft enlig kunne hjælpe med at forøge hastigheden i svingene. (henvis til peters afsnit)

## 12 Kommunikation mellem computer og bil

I opgaveformuleringen stilles visse krav til bilens kommunikation. Det skal være muligt at sende beskeder fra f.eks. en computer til bilen. Denne kommunikation skal som minimum

Side 18 af 26

Pole Position | 12. Kommunikation mellem computer og bil

kunne sætte bilens hastighed, og stoppe den igen. For at gøre det skal kommunikationen leve op til en protokol, som er dikteret i opgaveoplægget. Protokollen nødvendiggør at der skal sendes tre bytes hver gang. De tre bytes som sendes af sted har hver deres funktion. Den første byte beskriver typen af besked, anden byte er kommandoen, mens tredje byte er data som skal overføres til bilen. Protokollen kræver kun tre forskellige typer af beskeder, disse tre typer kan ses herunder.

Hex Værdi | Type | Bemærkning
0x55 | SET | Bruges til at sætte/aktivere en værdi i bilen. Kræver intet svar.
0xAA | GET | Bruges til at hente en værdi i bilen.
0xBB | REPLY | Er et svar på en GET besked.

Tabel 2: Forskellige typer af beskeder

Typen er efterfulgt af en kommando. Det kræves at der minimum er start og stop kommandoer. Protokollen er dog blevet udvidet så den indeholder en del flere kommandoer. Dette er gjort så det i højere grad er lettere at lave test på bilen. F.eks. er det muligt at måle bilens fart eller accelerationen vinkelret på bilen. I det følgende skema kan de forskellige kommandoer ses.

Hex Værdi | Type | Bemærkning
0x10 | Start | Dataværdi mellem 0 og 100
0x11 | Stop | Dataværdi er underordnet
0x12 | Register | Dataværdi mellem 0 og 25
0x13 | MapH | MSB af banelængden
0x14 | MapL | LSB af banelængden
0x15 | Acc | Returnerer en værdi mellem 0 og 255
0x16 | Speed | Periode tiden fra Sensor
0xBB | Error | Sendes tilbage 3 gange ved fejl

Tabel 3: Forskellige kommandoer

Start kommandoen bruges til at sætte bilens hastighed. Hastigheden sendes som et procenttal mellem 0-100%. Dette tal skal konverteres til hex inden afsendelse. Hexværdien

skal derfor være mellem 0x00-0x64. Hvis en værdi højere end 0x64 sendes, skal bilen ignorere beskeden, da der er tale om en ugyldig besked.

Stop kommandoen bruges til at stoppe bilen. Det er ikke afgørende hvilken data værdi som sendes af sted med stop kommandoen, dog skal der i alt sendes tre bytes af sted, da bilen forventer dette. Man kan således ikke blot sende 0x55 0x11.

Register kommandoen er indført så der lettere kan udføres debugging. Kommandoen efterfølges med en værdi mellem 20 og 25. Hvis der f.eks. skrives ”Get Register 25” svarer bilen tilbage med Reply Register og værdien i register 25. I dette tilfælde befinder bilens fart sig i register 25. Dette muliggør at man f.eks. kan tjekke om bilen har modtaget den

Side 19 af 26

Pole Position | 13. Litteraturliste

set besked som skulle starte bilen.

MapH og MapL er tælleregistrer. Disse to registre udgør tilsammen et 16-bit register som bruges til at tælle antal pulses fra wheelspeedsensoren. På denne måde er det muligt at måle hvor langt bilen har kørt. Når den hvide linje krydses sendes værdierne fra disse registre til f.eks. computeren, herefter nulstilles registrene. Dette blev implementeret så der kunne laves test på hvor konsistent wheelspeedsensoren er. Det 16-bit register tillader
en teoretisk max bane længde på | Dette kan der læses nærmere om i bilag

Hvilket
bilag?
Acc kommandoen bruges til at aflæse ADC’en som er koblet til accelerometeret. På lige
strækninger er denne værdi omkring 128 |

Speed kommandoen anvendes hvis man ønsker at måle bilens fart. Denne kommando er blevet implementeret for at kunne debugge i den del af programmet som sørger for at bilen
kører med konstant hastighed |

Error er svaret på alle ikke kendte beskeder. Dvs. hvis man sender en ikke gyldig kommando til bilen, så svarer den tilbage med 0xBB 0xBB 0xBB.

ATMega32 chippen indeholder et USART modul. USART er et initialord for universal synchronous/asynchronous receiver/transmitter. I dette projekt bruges modulet dog bare som UART(universal asynchronous receiver/transmitter). Fordelen ved at benytte asyn-

kron dataoverførsel er at det ikke er nødvendigt med et fælles kloksignal. Da der ikke er et fælles kloksignal skal hver dataoverførsel indledes med et startbit, efterfulgt af 5-9 data bits og beskeden skal slutte med 0-2 stopbits. Det er også muligt at afsende et parity bit. Parity bittet kan bruges til at tjekke om der er fejl i det data som er modtaget. I dette projekt anvendes et start bit, 8 data bits og 1 stop bit. De otte data bits sendes af sted som et hex tal mellem 0x00 og 0xFF. Beskederne til bilen sendes trådløs fra f.eks. en computer via bluetooth.

## 13 Litteraturliste

### 13.1 Kilder

1. Søren Hassing og René Skov Hansen: Elektrofysik (E-ANA 1), supplerende noter.(PDF), Efterår 1997

2.

Side 20 af 26

Pole Position | 13.2 Datasheets

### 13.2 Datasheets

1. Atmega32A Atmel
2. CNY70 vishay

## 14 Ordliste

- Koerciv kraft: den modstående magnetisk intensitet.
- HB-kurve: en hysteresekurve

## 15 Symbolliste

Symbol | Betydning | Enhed
B-felt | Flux densitet | T
H-felt | Felt styrke | A m
µr | Relativ permeabilitet | -
µ0 | Permeabilitetskonstant | H m
Fmagn | Magnetisk kraft | N

Side 21 af 26

Pole Position | 16. Bilag

## 16 Bilag

Side 22 af 26

Pole Position | 16.1 Elektromagnet-kraftmåling

### 16.1 Elektromagnet-kraftmåling

Formål

Formålet med denne journal er at undersøge muligheden for en elektromagnet til at holde bilen på banen i svingene. For at opnå bedst mulige omgangs tid, bør elektromagnet undersøges for om man kan lave en effektiv løsning til at fastholde bilen, så den ikke skrider i sving, med max hastighed. Der laves en prøve magnet, der har pasform til at kunne placeres under bilen. Samtidig skal der testes for hvor meget kræften falder med i forhold til afstand mellem magneten og skinnerne. Derudover testes permanent magneten for hvor stærk den er og sammenlignes herefter med elektromagneten.

Materiale liste

- Materiale af stål
- Kobbertråd af 0.25 mm
- Strømforsyning
- Pasco Force sensor
- Bilens permanent magnet
- Magnetisk metal plade
- Papir af 0.2 mm tykkelse
- Program, PASCO capstone
- Computer

Opstilling

1. Der skæres og slibes en magnet af ferromagnetisk materiale
2. Der vikles vindinger rund om magneten indtil en bredde på 4 mm er ca. opfyldt, da der er 6 mm bilens undervogn til skinnerne, skal der opnås en måling på 2 mm luftgab.
3. Force sensoren placeres så den kan måle magnetens kraft når den trækkes af, en metal plade
4. En computer med programmet PASCO capstone som kan læse kraft målingerne.

Forsøgs beskrivelse

Forsøget går ud på at lave en elektromagnet der kan sidde under bilen, derfor laves en test magnet af 660 vindinger da der ikke kan være så flere vindinger. En kraftmåler opstilles så den kan måle begge elektromagneters ender, der sættes 14 V over elektromagneten og kraften måles nu ved at trække elektromagneten af kraftmåleren. Forsøget gentages nu med et stykke papir på 0,2 mm, dernæst 0,4 mm, indtil vi når op på 2mm. Permanentmagneten testes, den sættes på kraftmåleren og der trækkes ned af, hvor målingerne nu er gemt på

Side 23 af 26

Pole Position | 16.1 Elektromagnet-kraftmåling

computeren.

Data

De nedestående data er et førsøg der er gentaget 3 gange og og luftgabet er lavet med flere stykker 0.2 mm papir, resultaterne er i Newton.
Luftgab | 0 | 0.2 | 0.4 | 0.6 | 0.8 | 1 | 1.2 | 1.4 | 1.6 | 1.8 | 2
Forsøg 1 | 1.345 | 1.320 | 1.090 | 1.100 | 1.090 | 1.130 | 1.060 | 1.090 | 0.930 | 0.970 | 0.960
Forsøg 2 | 1.570 | 1.150 | 1.350 | 1.320 | 1.120 | 1.050 | 1.000 | 1.060 | 1.040 | 0.950 | 0.870
Forsøg 3 | 1.000 | 1.440 | 1.350 | 1.100 | 1.200 | 1.200 | 1.200 | 1.100 | 1.000 | 0.930 | 0.980
Gennemsnit | 1.305 | 1.303 | 1.263 | 1.173 | 1.137 | 1.127 | 1.087 | 1.083 | 0.990 | 0.950 | 0.937

Resultater

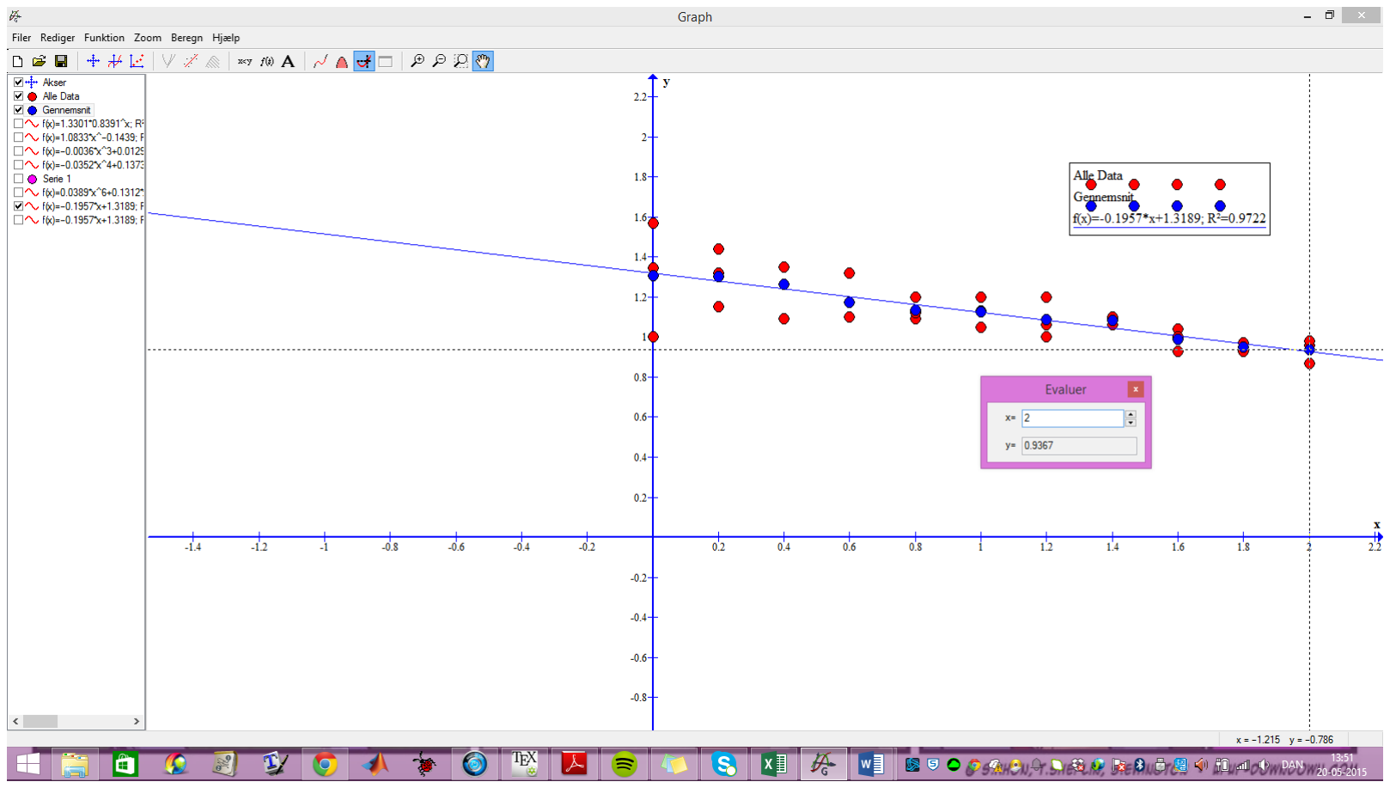
[picture p19: figure]

Figur 6: Data sættet i graf

Her ligger punkterne over data sættet, hvor de røde punkter er data for alle forsøgene og de blå er gennemsnittet af disse forsøg. Vi får nu at der er en kraft på 0.9367 N, ved luftgabet på 2 mm.

Udregninger

Vi udregner hvordan elektromagneten ville virke under ideele forhold, det vil sige hvis, der ikke var nogen flux spredning i elektromagneten. For udregningerne begynder antages det at materialet er en negering af jern, som ligger mellem 300-500 relativ permeabilitet.

Hj lj + 2Hgx = IN

Hj =

Bj
µ0µr

, Hg =

Bg
µ0

Ved at antage at der ikke er nogen spredning i luftgabet er Bg = Bj som nu giver:

Bg
µ0µr

∗ lj + 2 ∗

Bg
µ0

= IN

Side 24 af 26

Pole Position | 16.2 Beregning af gearing

### 16.2 Beregning af gearing

For at udregne hvor langt hjulet drejer på en puls og hvor mange pulse der skal til for at hjulet drejer en hel omgang skal gearing udregnes.
Dette udregnes ved at kigger på de 2 tandhjul som er henholdsvis gear 1 og 2. Der kigges på begge tandhjul og deres tænder tælles. Ved at dividerer værdierne fås forholdet mellem tandhjulene.
Dette har givet følgende forhold:

Gear1 = 10/14 = 0,7143

Gear2 = 9/127 = 0,3333

Ligges gearene sammen:

Gear1 ∗ Gear2 = 0,7143 ∗ 0,3333 = 0,2381

Dette betyder at når motoren har drejet en omgang så har hjulet drejet 0,2381 omgange. Når sensoren giver en puls, har hjulet derfor kørt: 0,2381
4 = 0,0595
Da hjulet er 8.5 cm i omkreds så svarer 1 puls til: 0,0595 ∗ 8,5 = 0,50595

### 16.2.1 Periode tid ved 4 m/s

Her udregnes periode tiden for signalet ved en hastighed på 4 m/s:

4m/s
0,085m

= 47,1RP S

Når hjulet har kørt en omgang har motoren altså kørt:

(

27
9

) ∗ (

14
10

) = 4,2

Så motoren kører: 47,1RP S ∗ 4,2 = 197,82RP S = 11869,2RPM Så der er: 197,82RP S ∗ 4 = 791,28P P S
1/791,28 = 0,001265sekunder

Dette giver altså en periode tid på: 1,26ms

### 16.3 Lookup Table - Bremse Værdi

lav en
beregning fra
tid til
m/s, og

forklar
hvad
enhed
tiden er

lav en
beregning fra
tid til
m/s, og

forklar
hvad
enhed
Peter Gilsaa, Mads Tilgaard Jensen, Eskild Andresen, | tiden er
Side 25 af 26

Pole Position | 16.3 Lookup Table - Bremse Værdi
Tid mellem pulses | Hastighed(m/s) | Bremselængde(m) | Bremselængde(pulse)
10 | 7,906 | 0,145596591 | 29
11 | 7,188 | 0,129261364 | 26
12 | 6,589 | 0,115648674 | 23
13 | 6,082 | 0,104130245 | 21
14 | 5,647 | 0,094257305 | 19
15 | 5,271 | 0,085700758 | 17
16 | 4,941 | 0,078213778 | 15
17 | 4,651 | 0,07160762 | 14
18 | 4,392 | 0,06573548 | 13
19 | 4,161 | 0,060481459 | 12
20 | 3,953 | 0,055752841 | 11
21 | 3,765 | 0,051474567 | 10
22 | 3,594 | 0,047585227 | 9
23 | 3,438 | 0,044034091 | 9
24 | 3,294 | 0,040778883 | 8
25 | 3,163 | 0,037784091 | 7
26 | 3,041 | 0,035019668 | 7
27 | 2,928 | 0,032460017 | 6
28 | 2,824 | 0,030083198 | 6
29 | 2,726 | 0,027870298 | 6
30 | 2,635 | 0,025804924 | 5
31 | 2,550 | 0,023872801 | 5
32 | 2,471 | 0,022061435 | 4
33 | 2,396 | 0,020359848 | 4
34 | 2,325 | 0,018758356 | 4
35 | 2,259 | 0,017248377 | 3
36 | 2,196 | 0,015822285 | 3
37 | 2,137 | 0,01447328 | 3
38 | 2,081 | 0,013195275 | 3
39 | 2,027 | 0,011982809 | 2
40 | 1,977 | 0,010830966 | 2
41 | 1,928 | 0,00973531 | 2
42 | 1,882 | 0,008691829 | 2
43 | 1,839 | 0,007696882 | 2
44 | 1,797 | 0,006747159 | 1
45 | 1,757 | 0,005839646 | 1
46 | 1,719 | 0,004971591 | 1
47 | 1,682 | 0,004140474 | 1
48 | 1,647 | 0,003343987 | 1
49 | 1,614 | 0,002580009 | 1
50 | 1,581 | 0,001846591 | 0

Tabel 4: Table med udregnede værdier for hurtig brug

Side 26 af 26
