Crowdedlight/DreamTeamCar/CD/tidsplan.pdf

Nr. | Emne | Opgaver | Start dato Slut dato
| Test af Bane og Bil | | 04-04-2015
| | Bremselængde
| | Acceleration
| | Top hastighed | 22-04-2015
| | Permanemt magnet
| | Sving
| | Mapning af banen | 29-04-2015
| Omdrejning/hastighed
| | wheel speed
| Svingsensor
| | Magnetisk encoder
| | Digital acc
| | Analog acc
| | Gyro
| Effektivitet
| | Strøm sensor
| Startlinje
| | Optisk sensor
| Bremse
| | Kortslutning
| | Mekanisk bremsning
| | Elektromagnet
| Kommunikation
| | Kode
| | Algoritme
| | Protokol
| Rapport
| | Informationer
| | Resume
| | Indledning
| | Forord
| | Indhold
| | Diskussion
| | Konklusion
| | Perspektivering
| | Litteraturliste
| | Ordliste
| | Symbolliste
| | Bilag | 16-05-2015 30-05-2015

Tidsplan
