Crowdedlight/DreamTeamCar/Word Dokumenter/Gui.odt

Indsæt Gui image – Todo

Vi har udviklet et simplet gui værktøj til brug under udviklingen af softwaren til bilen. Gui'et forbindes gennem bluetooth til bilen og kan så sende og modtage kommandoer. Alt kommunikation mellem program og bil går gennem det hvide vindue til venstre. Denne kommunikation kan man så vælge at gemme i en tekstfil hvis man ønsker.

Programmet opsnapper visse kommandoer som den modtager og opdaterer automatisk gui elementer. f.eks. hvis programmet modtager kommandoen for at bilen har kørt over den hvide streg så inkrementeres ”lapcounter” automatisk. Det samme er gældende for progressbaren som viser motorenes fart i procent.

Selve programmet er skrevet i VB.NET, som er et programmeringssprog fra Microsoft, da det var noget vi havde kendskab til på forhånd og var let at bygge videre på. Der blevet fundet en grundskabelon som vi byggede videre på og dermed skabte viste gui.

Det var meningen at gui også skulle kunne vise banen som bilen mapper når den kører rundt, så man kan se hvor godt den mapper og om der evt. er fejl. Dette nåede dog ikke at blive lavet grundet tidspres. Da dette værktøj blot var til brug i udviklingen og ikke direkte indgår i problemet der skal løses blev gui'et ikke prioriteret.
