Crowdedlight/DreamTeamCar/Word Dokumenter/Git For Dummies.docx

# Git For Dummies

## Ligge repository ned på din computer

1. Open CMD
2. Brug ”cd” til at gå hen hvor du vil have git mappen liggende
3. Skriv: ”Git clone https://github.com/Crowdedlight/DreamTeamCar.git”

## Hente sidste nye opdateringer fra serveren

1. Gå til git mappen med ”CD” i CMD
2. Skriv ”Git pull”
3. Done, Hvis der er merge konflikts fix dem og commit og pull igen

## Ligge dit arbejde op på serveren

1. Stå i mappe rod med CMD
2. Start med at opdaterer din mappe med ”Git Pull”
3. Tilføj filer du vil ”pushe” med ”Git add .” ( punktum tilføjer alle. Hvis du har slettet filer og ønsker dem slettet på serveren brug ”Git add --all”. Ønskes kun en enkelt eller flere filer pushet brug ”Git add FILNAVN”
4. Når ønskede filer er tilføjet commit dem med: ”Git commit –m ”BESKED”” Besked er hvor du skriver hvad dette commit er. F.eks: ”Git commit –m ”fikset Eskilds kode igen….””
5. Når commit er done og ønskes pushet til server bruges ”Git Push Orgin BRANCHNAME” BRANCHNAME er navnet på den branch der skal pushes til. Hvilket skal være den branch du står i/har commitet i.

Det er muligt at lave flere commits inden du pusher til serveren. Du kan også slå commits sammen, for at undgå en forvirrende historie med rigtig mange små ubetydelige commits. For at slå dem sammen benyttes kommandoen ”squash” –Hvis du ønsker at gøre dette, Google det og forstå det inden du gør det. Er forholdsvis lige til, men kan gå galt.

Du kan også gemme commits. Så hvis du har ændringer der ikke er gemt og du skifter branch skal du gemme dine ændringer. Hvis du ikke vil committe dem da de er halvfærdige benyttes ”Stash” kommandoen til at gemme dem til næste gang du kommer hvor du så kan kalde dem frem igen. Endnu engang skal ”git stash” googles og forstås inden det benyttes. Kan let gå galt og lave rod i det.
