Crowdedlight/DreamTeamCar/Tex Filer/Graphics/CNY70-Diode.jpg

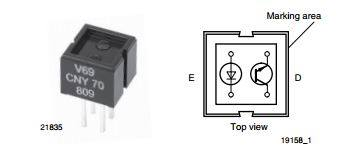
Tex Filer/Graphics/CNY70-Diode.jpg
