Crowdedlight/DreamTeamCar/Tex Filer/Graphics/Elektromagnet.jpg

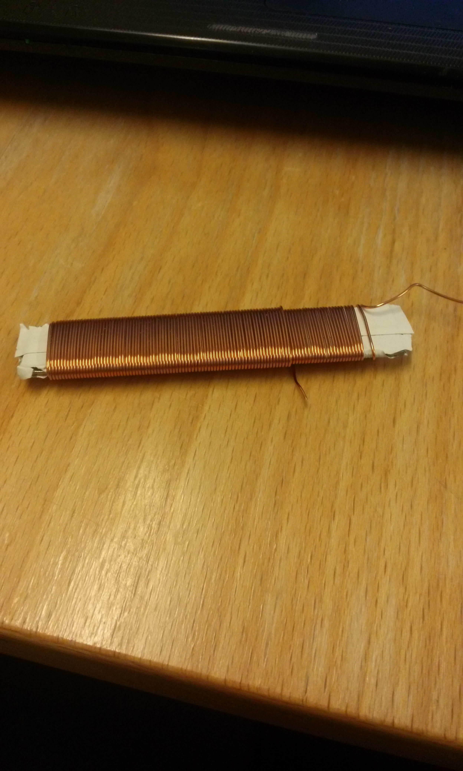
Tex Filer/Graphics/Elektromagnet.jpg
