Crowdedlight/DreamTeamCar/Tex Filer/Graphics/Elektromagnet_2D.jpg

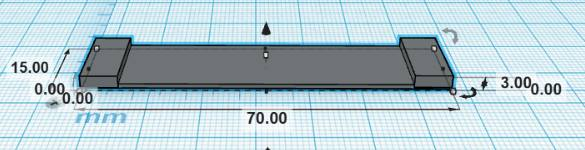
Tex Filer/Graphics/Elektromagnet_2D.jpg
