Crowdedlight/DreamTeamCar/Tex Filer/Include/testbane.tex

\subsection{Testbane Billede}
\label{testbanebillede}

\begin{figure}[h!]
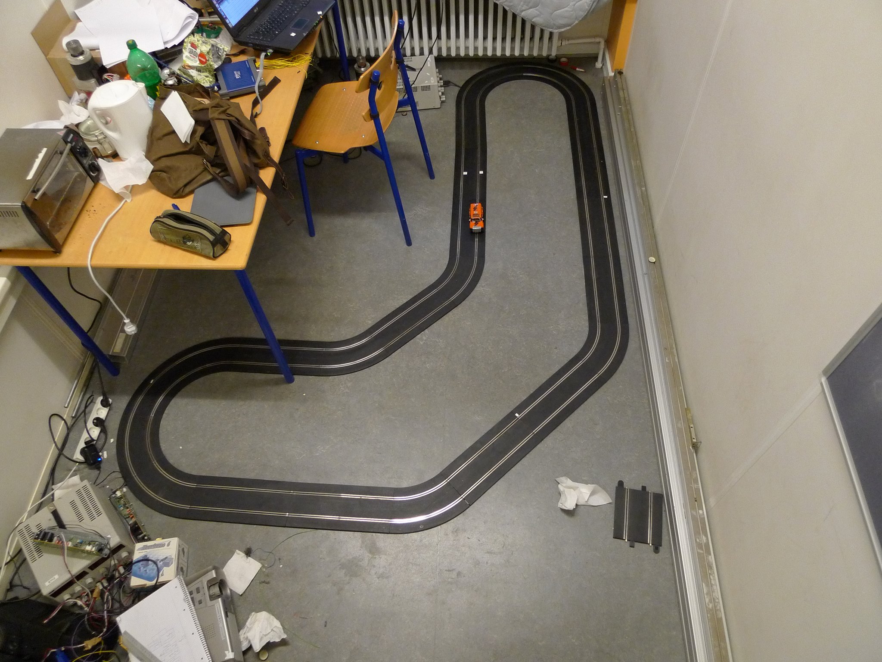
[picture p24: Tex Filer/Graphics/testbane.jpg]

\caption{Billede af testbanen hvor accelerometeret testet på.}
\end{figure}
