Crowdedlight/DreamTeamCar/Tex Filer/Graphics/Graf_Elektromagnet_resultater.jpg

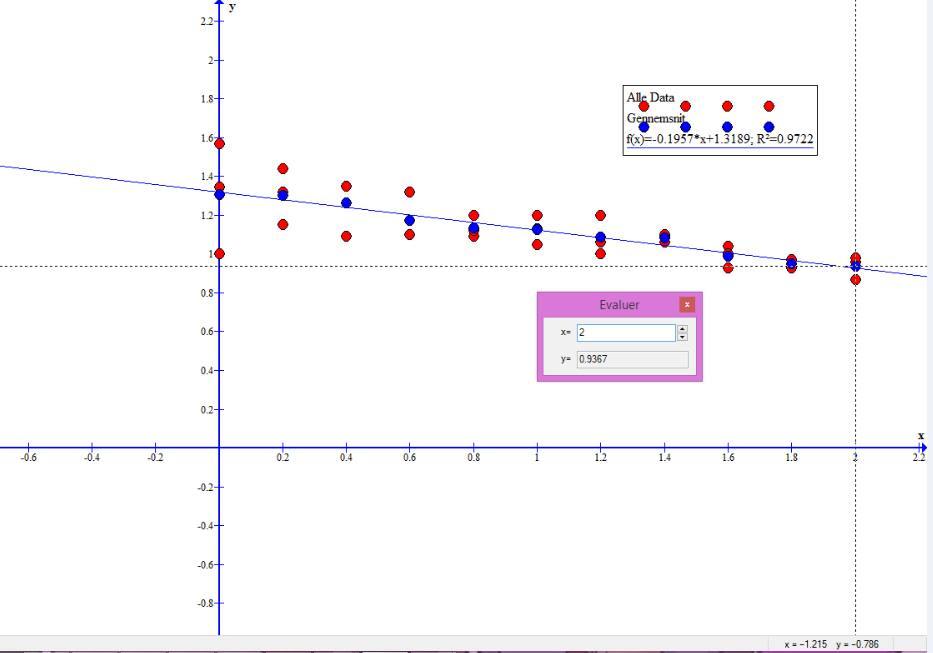
Tex Filer/Graphics/Graf_Elektromagnet_resultater.jpg
