Crowdedlight/DreamTeamCar/CD/Sensorboard_tegning.pdf

# CNY70

# TCST1230

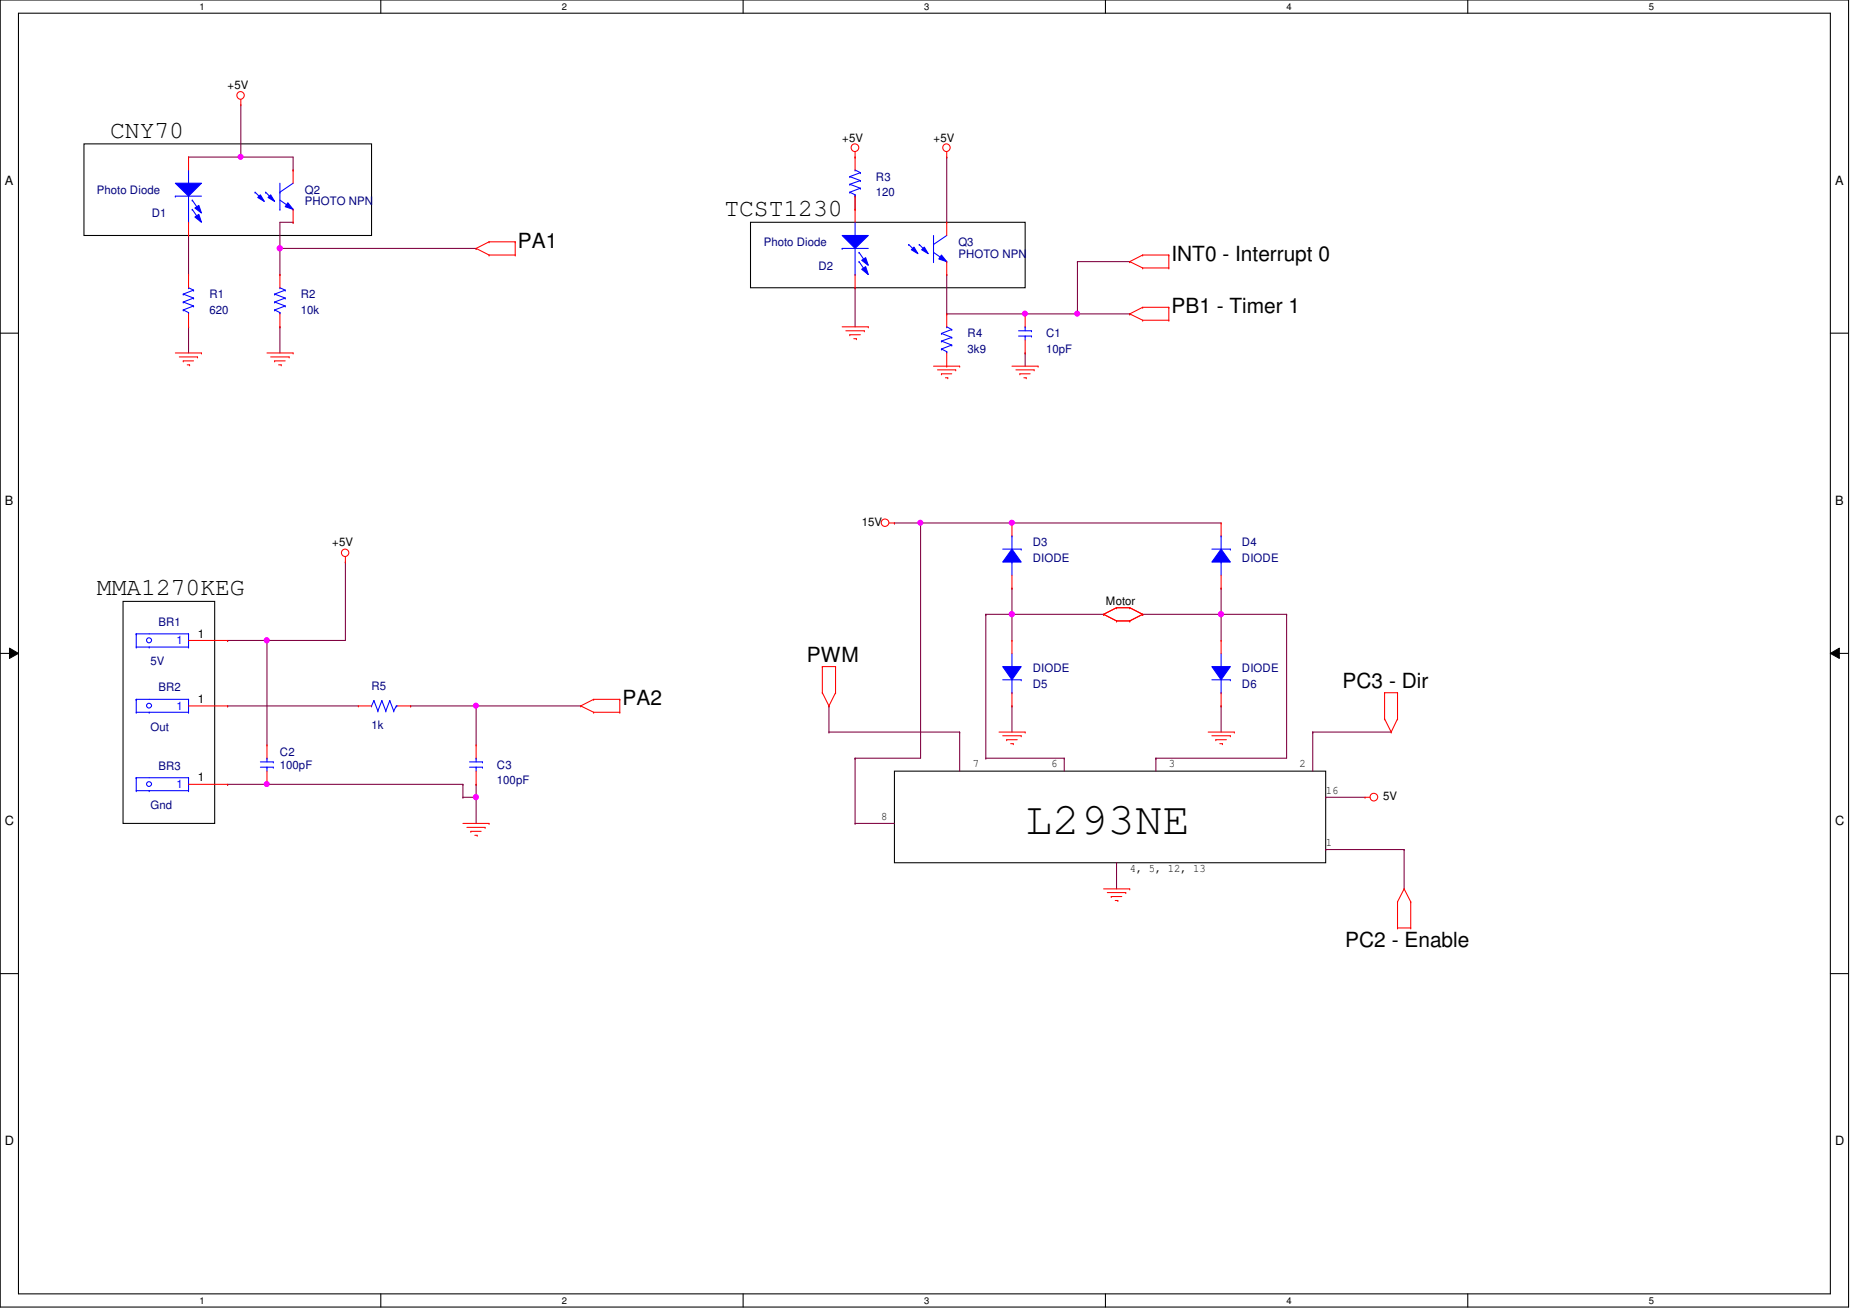
[picture p26: page 1]
