Crowdedlight/DreamTeamCar/(list of files, drawings)

Other design files:
Car Schematics/CARPROJECT.DSN
Car Schematics/CarProject.opj
