Crowdedlight/DreamTeamCar/(commit log)

2015-05-06 tilføjet interrupt 10ms
2015-05-07 added recieve interrupt
2015-05-11 git ignore fil fixet og kode med interrupt
2015-05-19 Tilføjet Kredsløb Design i fil og billede
    [CARPROJECT.DSN, CarProject.opj]
2015-05-22 fikset fejl i schematics
    [CARPROJECT.DSN, CarProject.opj]
2015-05-25 tilføjet gearing beregning og henvisinger i fart/afstand filer
2015-05-26 repport done at last
    [Lookup-Tabel-Bremse.xlsx]
